unal-edigital1-2019-2/work04-proyectofinal-grupo-02-1/docs/figs/Diagrama2.jpeg

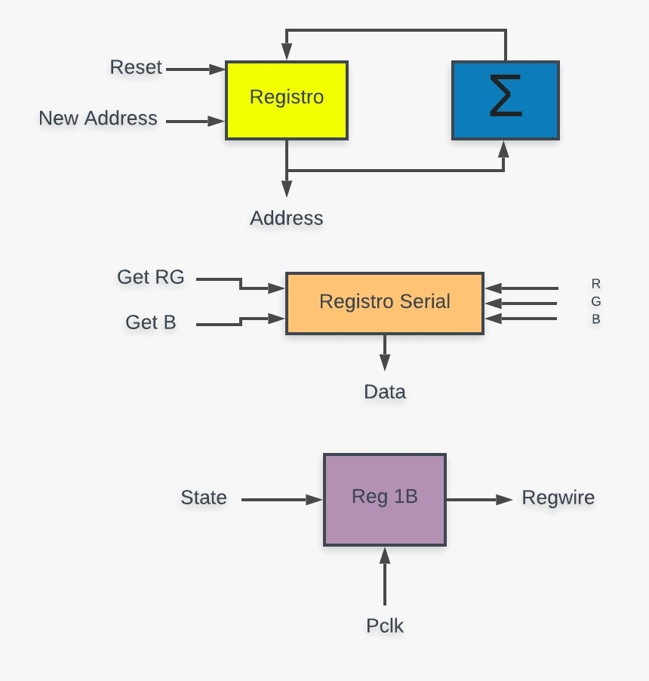
docs/figs/Diagrama2.jpeg
