unal-edigital1-2019-2/work04-proyectofinal-grupo-02-1/docs/figs/Proyecto-05.jpeg

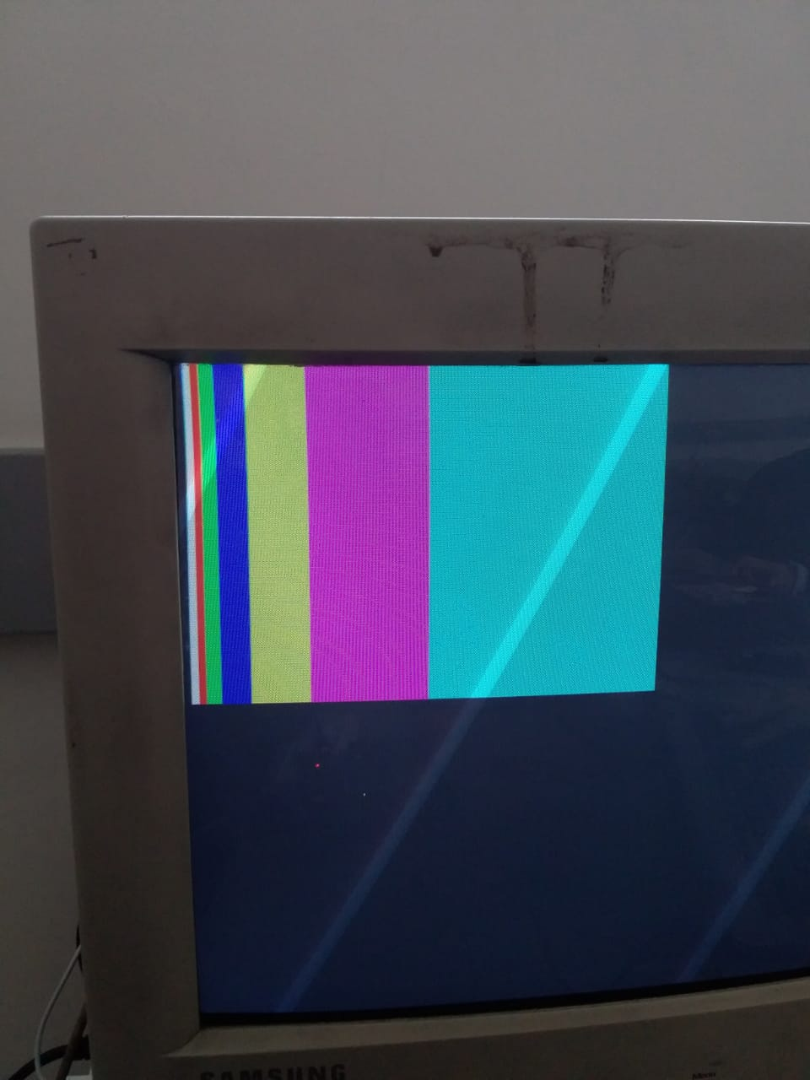
docs/figs/Proyecto-05.jpeg
