unal-edigital1-2019-2/work04-proyectofinal-grupo-02-1/docs/figs/Simulacion-00.png

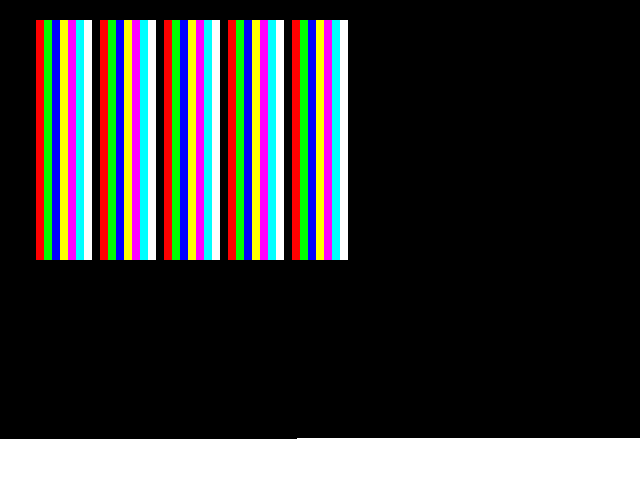
docs/figs/Simulacion-00.png
