unal-edigital1-2019-2/work04-proyectofinal-grupo-02-1/(list of files, cad)

Other CAD files:
hdl/isim/test_cam_TB_isim_beh.exe.sim/work/test_cam_TB_isim_beh.exe_main.nt64.obj
hdl/isim/test_cam_TB_isim_beh.exe.sim/unisims_ver/m_00000000004277362592_3949463703.nt64.obj
hdl/isim/test_cam_TB_isim_beh.exe.sim/work/m_00000000001073926473_1206468233.nt64.obj
hdl/isim/test_cam_TB_isim_beh.exe.sim/unisims_ver/m_00000000003266096158_2593380106.nt64.obj
hdl/isim/test_cam_TB_isim_beh.exe.sim/work/m_00000000002068633926_3409011990.nt64.obj
hdl/isim/test_cam_TB_isim_beh.exe.sim/work/m_00000000001964925841_2406606927.nt64.obj
hdl/isim/test_cam_TB_isim_beh.exe.sim/work/m_00000000004134447467_2073120511.nt64.obj
hdl/isim/test_cam_TB_isim_beh.exe.sim/work/m_00000000000293240281_0898626419.nt64.obj
hdl/isim/test_cam_TB_isim_beh.exe.sim/work/m_00000000001994499703_2888191379.nt64.obj
hdl/isim/test_cam_TB_isim_beh.exe.sim/work/m_00000000001433017019_1742765518.nt64.obj
