unal-edigital1-2019-2/work04-proyectofinal-grupo-02-1/hdl/par_usage_statistics.html

Par Statistics

Total Non-vccgnd Signals=209

Total Non-vccgnd Design Pins=2888

Total Non-vccgnd Conns=2888

Total Non-vccgnd Timing Constrained Conns=2757

Phase 1 CPU=62.1 sec

Phase 2 CPU=63.8 sec

Phase 3 CPU=68.9 sec

Phase 4 CPU=114.2 sec

Phase 5 CPU=118.2 sec

Phase 6 CPU=118.2 sec

Phase 7 CPU=118.2 sec

Phase 8 CPU=118.2 sec

Phase 9 CPU=119.3 sec

AvgWirelenPerPin Fanout 1=17.0

AvgWirelenPerPin Fanout 2=27.5

AvgWirelenPerPin Fanout 3=12.3

AvgWirelenPerPin Fanout 4=7.8

AvgWirelenPerPin Fanout 10=9.4

AvgWirelenPerPin Fanout 50=5.4

AvgWirelenPerPin Fanout 100=15.2

AvgWirelenPerPin Fanout 500=4.9

AvgWirelenPerPin Fanout 5000=0.0

AvgWirelenPerPin Fanout 20000=0.0

AvgWirelenPerPin Fanout 50000=0.0

AvgWirelenPerPin Fanout 100000=0.0

IRR Gamma=1.0083
