unal-edigital1-2019-2/work04-proyectofinal-grupo-02-1/hdl/usage_statistics_webtalk.html

### Device Usage Page (usage_statistics_webtalk.html)

This HTML page displays the device usage statistics that will be sent to Xilinx.

Software Version and Target Device
Product Version: | ISE:14.7 (WebPack) - P.20131013 | Target Family: | Artix7
OS Platform: | NT64 | Target Device: | xc7a100t
Project ID (random number) | fe5249351b4f4ad88650da59bd6b6d94.874A876191364FBEB39825A02CC45C05.1 | Target Package: | csg324
Registration ID | 211795229_0_0_235 | Target Speed: | -3
Date Generated | 2020-02-10T19:30:09 | Tool Flow | ISE

User Environment
OS Name | Microsoft , 64-bit | OS Release | major release (build 9200)
CPU Name | Intel(R) Core(TM) i5-4300U CPU @ 1.90GHz | CPU Speed | 2494 MHz
OS Name | Microsoft , 64-bit | OS Release | major release (build 9200)
CPU Name | Intel(R) Core(TM) i5-4300U CPU @ 1.90GHz | CPU Speed | 2494 MHz

Device Usage Statistics
Macro Statistics | Miscellaneous Statistics | Net Statistics | Site Usage

Adders/Subtractors=1

17-bit adder=1

Comparators=8

10-bit comparator greater=4

10-bit comparator lessequal=1

9-bit comparator greater=2

9-bit comparator lessequal=1

Counters=2

10-bit up counter=1

9-bit up counter=1

FSMs=1 MACs=1

9x9-to-17-bit MAC=1

Multiplexers=2

17-bit 2-to-1 multiplexer=1

8-bit 2-to-1 multiplexer=1

RAMs=1

131072x8-bit dual-port block RAM=1

Registers=26

Flip-Flops=26

MiscellaneousStatistics

AGG_BONDED_IO=31

AGG_IO=31

AGG_LOCED_IO=31

AGG_SLICE=52

NUM_BONDED_IOB33=31

NUM_BSFULL=48

NUM_BSLUTONLY=64

NUM_BSUSED=112

NUM_BUFG=5

NUM_LOCED_IOB33=31

NUM_LOGIC_O5ANDO6=15

NUM_LOGIC_O5ONLY=37

NUM_LOGIC_O6ONLY=55

NUM_LUT_RT_DRIVES_CARRY4=5

NUM_LUT_RT_EXO6=5

NUM_LUT_RT_O6=37

NUM_MMCME2_ADV=1

NUM_RAMB36E1=32

NUM_SLICEL=52

NUM_SLICE_CARRY4=17

NUM_SLICE_CONTROLSET=5

NUM_SLICE_CYINIT=169

NUM_SLICE_FF=49

NUM_SLICE_UNUSEDCTRL=30

NUM_UNUSABLE_FF_BELS=23

NetStatistics

NumNets_Active=240

NumNets_Gnd=1

NumNets_Vcc=1

NumNodesOfType_Active_BENTQUAD=177

NumNodesOfType_Active_BOUNCEACROSS=76

NumNodesOfType_Active_BOUNCEIN=49

NumNodesOfType_Active_BUFGROUT=5

NumNodesOfType_Active_BUFINP2OUT=8

NumNodesOfType_Active_CLKPIN=157

NumNodesOfType_Active_DOUBLE=509

NumNodesOfType_Active_GENERIC=18

NumNodesOfType_Active_GLOBAL=145

NumNodesOfType_Active_HLONG=35

NumNodesOfType_Active_HQUAD=217

NumNodesOfType_Active_INPUT=2370

NumNodesOfType_Active_IOBIN2OUT=25

NumNodesOfType_Active_IOBOUTPUT=25

NumNodesOfType_Active_LUTINPUT=350

NumNodesOfType_Active_OUTBOUND=187

NumNodesOfType_Active_OUTPUT=201

NumNodesOfType_Active_PADINPUT=11

NumNodesOfType_Active_PADOUTPUT=14

NumNodesOfType_Active_PINBOUNCE=137

NumNodesOfType_Active_PINFEED=4501

NumNodesOfType_Active_SINGLE=602

NumNodesOfType_Active_VLONG=68

NumNodesOfType_Active_VLONG12=54

NumNodesOfType_Active_VQUAD=205

NumNodesOfType_Gnd_BOUNCEIN=271

NumNodesOfType_Gnd_CLKPIN=131

NumNodesOfType_Gnd_HVCCGNDOUT=170

NumNodesOfType_Gnd_INPUT=924

NumNodesOfType_Gnd_IOBIN2OUT=6

NumNodesOfType_Gnd_IOBOUTPUT=6

NumNodesOfType_Gnd_PADINPUT=6

NumNodesOfType_Gnd_PINBOUNCE=195

NumNodesOfType_Gnd_PINFEED=1062

NumNodesOfType_Vcc_HVCCGNDOUT=53

NumNodesOfType_Vcc_INPUT=129

NumNodesOfType_Vcc_LUTINPUT=52

NumNodesOfType_Vcc_PINFEED=181

SiteStatistics

BUFG-BUFGCTRL=5

IOB33-IOB33M=14

IOB33-IOB33S=15

RAMB36E1-RAMBFIFO36E1=32

SLICEL-SLICEM=15

SiteSummary

BUFG=5

BUFG_BUFG=5

CARRY4=17

FF_INIT=1

HARD0=5

IOB33=31

IOB33_INBUF_EN=14

IOB33_OUTBUF=17

LUT5=52

LUT6=112

MMCME2_ADV=1

MMCME2_ADV_MMCME2_ADV=1

PAD=31

RAMB36E1=32

RAMB36E1_RAMB36E1=32

REG_INIT=48

SLICEL=52

Configuration Data

FF_INIT

CK=[CK:1] [CK_INV:0]

FFINIT=[INIT1:1]

FFSR=[SRHIGH:1]

SYNC_ATTR=[SYNC:1]

IOB33_INBUF_EN

IBUF_LOW_PWR=[TRUE:14]

MMCME2_ADV

CLKINSEL=[CLKINSEL:1] [CLKINSEL_INV:0]

PSEN=[PSEN_INV:0] [PSEN:1]

PSINCDEC=[PSINCDEC:1] [PSINCDEC_INV:0]

PWRDWN=[PWRDWN_INV:0] [PWRDWN:1]

RST=[RST:1] [RST_INV:0]

MMCME2_ADV_MMCME2_ADV

BANDWIDTH=[OPTIMIZED:1]

CLKBURST_ENABLE=[FALSE:1]

CLKBURST_REPEAT=[FALSE:1]

CLKFBIN_EDGE=[FALSE:1]

CLKFBIN_NOCOUNT=[TRUE:1]

CLKFBOUT_EDGE=[FALSE:1]

CLKFBOUT_EN=[TRUE:1]

CLKFBOUT_FRAC_EN=[FALSE:1]

CLKFBOUT_FRAC_WF_FALL=[FALSE:1]

CLKFBOUT_FRAC_WF_RISE=[FALSE:1]

CLKFBOUT_NOCOUNT=[TRUE:1]

CLKFBOUT_USE_FINE_PS=[FALSE:1]

CLKINSEL=[CLKINSEL:1] [CLKINSEL_INV:0]

CLKOUT0_EDGE=[FALSE:1]

CLKOUT0_EN=[FALSE:1]

CLKOUT0_FRAC_EN=[FALSE:1]

CLKOUT0_FRAC_WF_FALL=[FALSE:1]

CLKOUT0_FRAC_WF_RISE=[FALSE:1]

CLKOUT0_NOCOUNT=[TRUE:1]

CLKOUT0_USE_FINE_PS=[FALSE:1]

CLKOUT1_EDGE=[FALSE:1]

CLKOUT1_EN=[FALSE:1]

CLKOUT1_NOCOUNT=[TRUE:1]

CLKOUT1_USE_FINE_PS=[FALSE:1]

CLKOUT2_EDGE=[FALSE:1]

CLKOUT2_EN=[FALSE:1]

CLKOUT2_NOCOUNT=[TRUE:1]

CLKOUT2_USE_FINE_PS=[FALSE:1]

CLKOUT3_EDGE=[FALSE:1]

CLKOUT3_EN=[FALSE:1]

CLKOUT3_NOCOUNT=[TRUE:1]

CLKOUT3_USE_FINE_PS=[FALSE:1]

CLKOUT4_CASCADE=[FALSE:1]

CLKOUT4_EDGE=[FALSE:1]

CLKOUT4_EN=[FALSE:1]

CLKOUT4_NOCOUNT=[TRUE:1]

CLKOUT4_USE_FINE_PS=[FALSE:1]

CLKOUT5_EDGE=[FALSE:1]

CLKOUT5_EN=[FALSE:1]

CLKOUT5_NOCOUNT=[TRUE:1]

CLKOUT5_USE_FINE_PS=[FALSE:1]

CLKOUT6_EDGE=[FALSE:1]

CLKOUT6_EN=[FALSE:1]

CLKOUT6_NOCOUNT=[TRUE:1]

CLKOUT6_USE_FINE_PS=[FALSE:1]

COMPENSATION=[BUF_IN:1]

DIRECT_PATH_CNTRL=[FALSE:1]

DIVCLK_EDGE=[FALSE:1]

DIVCLK_NOCOUNT=[TRUE:1]

EN_VCO_DIV1=[FALSE:1]

EN_VCO_DIV6=[FALSE:1]

GTS_WAIT=[FALSE:1]

HVLF_CNT_TEST_EN=[FALSE:1]

INTERP_TEST=[FALSE:1]

IN_DLY_EN=[TRUE:1]

LF_LOW_SEL=[FALSE:1]

MMCM_EN=[TRUE:1]

PERF0_USE_CLK=[FALSE:1]

PERF1_USE_CLK=[FALSE:1]

PERF2_USE_CLK=[FALSE:1]

PERF3_USE_CLK=[FALSE:1]

PSEN=[PSEN_INV:0] [PSEN:1]

PSINCDEC=[PSINCDEC:1] [PSINCDEC_INV:0]

PWRDWN=[PWRDWN_INV:0] [PWRDWN:1]

RST=[RST:1] [RST_INV:0]

SEL_HV_NMOS=[FALSE:1]

SEL_LV_NMOS=[FALSE:1]

SEL_SLIPD=[FALSE:1]

SS_EN=[FALSE:1]

SS_MODE=[CENTER_HIGH:1]

STARTUP_WAIT=[FALSE:1]

SUP_SEL_AREG=[FALSE:1]

SUP_SEL_DREG=[FALSE:1]

TMUX_MUX_SEL=[00:1]

VLF_HIGH_DIS_B=[TRUE:1]

VLF_HIGH_PWDN_B=[TRUE:1]

RAMB36E1

CLKARDCLKL=[CLKARDCLKL:32] [CLKARDCLKL_INV:0]

CLKARDCLKU=[CLKARDCLKU_INV:0] [CLKARDCLKU:32]

CLKBWRCLKL=[CLKBWRCLKL_INV:0] [CLKBWRCLKL:32]

CLKBWRCLKU=[CLKBWRCLKU:32] [CLKBWRCLKU_INV:0]

ENARDENL=[ENARDENL_INV:0] [ENARDENL:32]

ENARDENU=[ENARDENU_INV:0] [ENARDENU:32]

ENBWRENL=[ENBWRENL:32] [ENBWRENL_INV:0]

ENBWRENU=[ENBWRENU_INV:0] [ENBWRENU:32]

REGCLKARDRCLKL=[REGCLKARDRCLKL_INV:0] [REGCLKARDRCLKL:32]

REGCLKARDRCLKU=[REGCLKARDRCLKU:32] [REGCLKARDRCLKU_INV:0]

REGCLKBL=[REGCLKBL_INV:0] [REGCLKBL:32]

REGCLKBU=[REGCLKBU:32] [REGCLKBU_INV:0]

RSTRAMARSTRAML=[RSTRAMARSTRAML_INV:0] [RSTRAMARSTRAML:32]

RSTRAMARSTRAMU=[RSTRAMARSTRAMU:32] [RSTRAMARSTRAMU_INV:0]

RSTRAMBL=[RSTRAMBL_INV:0] [RSTRAMBL:32]

RSTRAMBU=[RSTRAMBU:32] [RSTRAMBU_INV:0]

RSTREGARSTREGL=[RSTREGARSTREGL:32] [RSTREGARSTREGL_INV:0]

RSTREGARSTREGU=[RSTREGARSTREGU_INV:0] [RSTREGARSTREGU:32]

RSTREGBL=[RSTREGBL:32] [RSTREGBL_INV:0]

RSTREGBU=[RSTREGBU:32] [RSTREGBU_INV:0]

RAMB36E1_RAMB36E1

CLKARDCLKL=[CLKARDCLKL:32] [CLKARDCLKL_INV:0]

CLKARDCLKU=[CLKARDCLKU_INV:0] [CLKARDCLKU:32]

CLKBWRCLKL=[CLKBWRCLKL_INV:0] [CLKBWRCLKL:32]

CLKBWRCLKU=[CLKBWRCLKU:32] [CLKBWRCLKU_INV:0]

DOA_REG=[0:32]

DOB_REG=[0:32]

ENARDENL=[ENARDENL_INV:0] [ENARDENL:32]

ENARDENU=[ENARDENU_INV:0] [ENARDENU:32]

ENBWRENL=[ENBWRENL:32] [ENBWRENL_INV:0]

ENBWRENU=[ENBWRENU_INV:0] [ENBWRENU:32]

EN_ECC_READ=[FALSE:32]

EN_ECC_WRITE=[FALSE:32]

EN_PWRGATE=[NONE:32]

RAM_EXTENSION_A=[UPPER:16] [LOWER:16]

RAM_EXTENSION_B=[UPPER:16] [LOWER:16]

RAM_MODE=[TDP:32]

RDADDR_COLLISION_HWCONFIG=[DELAYED_WRITE:32]

READ_WIDTH_A=[1:32]

READ_WIDTH_B=[1:32]

REGCLKARDRCLKL=[REGCLKARDRCLKL_INV:0] [REGCLKARDRCLKL:32]

REGCLKARDRCLKU=[REGCLKARDRCLKU:32] [REGCLKARDRCLKU_INV:0]

REGCLKBL=[REGCLKBL_INV:0] [REGCLKBL:32]

REGCLKBU=[REGCLKBU:32] [REGCLKBU_INV:0]

RSTRAMARSTRAML=[RSTRAMARSTRAML_INV:0] [RSTRAMARSTRAML:32]

RSTRAMARSTRAMU=[RSTRAMARSTRAMU:32] [RSTRAMARSTRAMU_INV:0]

RSTRAMBL=[RSTRAMBL_INV:0] [RSTRAMBL:32]

RSTRAMBU=[RSTRAMBU:32] [RSTRAMBU_INV:0]

RSTREGARSTREGL=[RSTREGARSTREGL:32] [RSTREGARSTREGL_INV:0]

RSTREGARSTREGU=[RSTREGARSTREGU_INV:0] [RSTREGARSTREGU:32]

RSTREGBL=[RSTREGBL:32] [RSTREGBL_INV:0]

RSTREGBU=[RSTREGBU:32] [RSTREGBU_INV:0]

RSTREG_PRIORITY_A=[RSTREG:32]

RSTREG_PRIORITY_B=[RSTREG:32]

SAVEDATA=[FALSE:32]

WRITE_MODE_A=[WRITE_FIRST:32]

WRITE_MODE_B=[WRITE_FIRST:32]

WRITE_WIDTH_A=[1:32]

WRITE_WIDTH_B=[1:32]

REG_INIT

CK=[CK:48] [CK_INV:0]

FFINIT=[INIT0:43] [INIT1:5]

FFSR=[SRLOW:43] [SRHIGH:5]

LATCH_OR_FF=[FF:48]

SYNC_ATTR=[ASYNC:30] [SYNC:18]

SLICEL

CLK=[CLK:22] [CLK_INV:0]

Pin Data

BUFG

I0=5

O=5

BUFG_BUFG

I0=5

O=5

CARRY4

CIN=12

CO3=12

CYINIT=5

DI0=14

DI1=13

DI2=12

DI3=12

O0=17

O1=14

O2=13

O3=12

S0=17

S1=14

S2=13

S3=12

FF_INIT

CK=1

D=1

Q=1

SR=1

HARD0

0=5

IOB33

I=14

O=17

PAD=31

IOB33_INBUF_EN

OUT=14

PAD=14

IOB33_OUTBUF

IN=17

OUT=17

LUT5

A1=1

A2=3

A3=10

A4=11

A5=3

O5=52

LUT6

A1=31

A2=40

A3=45

A4=72

A5=91

A6=111

O6=112

MMCME2_ADV

CLKFBIN=1

CLKFBOUT=1

CLKIN1=1

CLKIN2=1

CLKINSEL=1

CLKOUT0=1

CLKOUT1=1

DADDR0=1

DADDR1=1

DADDR2=1

DADDR3=1

DADDR4=1

DADDR5=1

DADDR6=1

DCLK=1

DEN=1

DI0=1

DI1=1

DI10=1

DI11=1

DI12=1

DI13=1

DI14=1

DI15=1

DI2=1

DI3=1

DI4=1

DI5=1

DI6=1

DI7=1

DI8=1

DI9=1

DWE=1

PSCLK=1

PSEN=1

PSINCDEC=1

PWRDWN=1

RST=1

MMCME2_ADV_MMCME2_ADV

CLKFBIN=1

CLKFBOUT=1

CLKIN1=1

CLKIN2=1

CLKINSEL=1

CLKOUT0=1

CLKOUT1=1

DADDR0=1

DADDR1=1

DADDR2=1

DADDR3=1

DADDR4=1

DADDR5=1

DADDR6=1

DCLK=1

DEN=1

DI0=1

DI1=1

DI10=1

DI11=1

DI12=1

DI13=1

DI14=1

DI15=1

DI2=1

DI3=1

DI4=1

DI5=1

DI6=1

DI7=1

DI8=1

DI9=1

DWE=1

PSCLK=1

PSEN=1

PSINCDEC=1

PWRDWN=1

RST=1

PAD

PAD=31

RAMB36E1

ADDRARDADDRL0=32

ADDRARDADDRL1=32

ADDRARDADDRL10=32

ADDRARDADDRL11=32

ADDRARDADDRL12=32

ADDRARDADDRL13=32

ADDRARDADDRL14=32

ADDRARDADDRL15=32

ADDRARDADDRL2=32

ADDRARDADDRL3=32

ADDRARDADDRL4=32

ADDRARDADDRL5=32

ADDRARDADDRL6=32

ADDRARDADDRL7=32

ADDRARDADDRL8=32

ADDRARDADDRL9=32

ADDRARDADDRU0=32

ADDRARDADDRU1=32

ADDRARDADDRU10=32

ADDRARDADDRU11=32

ADDRARDADDRU12=32

ADDRARDADDRU13=32

ADDRARDADDRU14=32

ADDRARDADDRU2=32

ADDRARDADDRU3=32

ADDRARDADDRU4=32

ADDRARDADDRU5=32

ADDRARDADDRU6=32

ADDRARDADDRU7=32

ADDRARDADDRU8=32

ADDRARDADDRU9=32

ADDRBWRADDRL0=32

ADDRBWRADDRL1=32

ADDRBWRADDRL10=32

ADDRBWRADDRL11=32

ADDRBWRADDRL12=32

ADDRBWRADDRL13=32

ADDRBWRADDRL14=32

ADDRBWRADDRL15=32

ADDRBWRADDRL2=32

ADDRBWRADDRL3=32

ADDRBWRADDRL4=32

ADDRBWRADDRL5=32

ADDRBWRADDRL6=32

ADDRBWRADDRL7=32

ADDRBWRADDRL8=32

ADDRBWRADDRL9=32

ADDRBWRADDRU0=32

ADDRBWRADDRU1=32

ADDRBWRADDRU10=32

ADDRBWRADDRU11=32

ADDRBWRADDRU12=32

ADDRBWRADDRU13=32

ADDRBWRADDRU14=32

ADDRBWRADDRU2=32

ADDRBWRADDRU3=32

ADDRBWRADDRU4=32

ADDRBWRADDRU5=32

ADDRBWRADDRU6=32

ADDRBWRADDRU7=32

ADDRBWRADDRU8=32

ADDRBWRADDRU9=32

CASCADEINA=16

CASCADEINB=16

CASCADEOUTA=16

CASCADEOUTB=16

CLKARDCLKL=32

CLKARDCLKU=32

CLKBWRCLKL=32

CLKBWRCLKU=32

DIADI0=32

DIADI1=32

DOBDO0=16

ENARDENL=32

ENARDENU=32

ENBWRENL=32

ENBWRENU=32

REGCEAREGCEL=32

REGCEAREGCEU=32

REGCEBL=32

REGCEBU=32

REGCLKARDRCLKL=32

REGCLKARDRCLKU=32

REGCLKBL=32

REGCLKBU=32

RSTRAMARSTRAML=32

RSTRAMARSTRAMU=32

RSTRAMBL=32

RSTRAMBU=32

RSTREGARSTREGL=32

RSTREGARSTREGU=32

RSTREGBL=32

RSTREGBU=32

WEAL0=32

WEAL1=32

WEAL2=32

WEAL3=32

WEAU0=32

WEAU1=32

WEAU2=32

WEAU3=32

WEBWEL0=32

WEBWEL1=32

WEBWEL2=32

WEBWEL3=32

WEBWEL4=32

WEBWEL5=32

WEBWEL6=32

WEBWEL7=32

WEBWEU0=32

WEBWEU1=32

WEBWEU2=32

WEBWEU3=32

WEBWEU4=32

WEBWEU5=32

WEBWEU6=32

WEBWEU7=32

RAMB36E1_RAMB36E1

ADDRARDADDRL0=32

ADDRARDADDRL1=32

ADDRARDADDRL10=32

ADDRARDADDRL11=32

ADDRARDADDRL12=32

ADDRARDADDRL13=32

ADDRARDADDRL14=32

ADDRARDADDRL15=32

ADDRARDADDRL2=32

ADDRARDADDRL3=32

ADDRARDADDRL4=32

ADDRARDADDRL5=32

ADDRARDADDRL6=32

ADDRARDADDRL7=32

ADDRARDADDRL8=32

ADDRARDADDRL9=32

ADDRARDADDRU0=32

ADDRARDADDRU1=32

ADDRARDADDRU10=32

ADDRARDADDRU11=32

ADDRARDADDRU12=32

ADDRARDADDRU13=32

ADDRARDADDRU14=32

ADDRARDADDRU2=32

ADDRARDADDRU3=32

ADDRARDADDRU4=32

ADDRARDADDRU5=32

ADDRARDADDRU6=32

ADDRARDADDRU7=32

ADDRARDADDRU8=32

ADDRARDADDRU9=32

ADDRBWRADDRL0=32

ADDRBWRADDRL1=32

ADDRBWRADDRL10=32

ADDRBWRADDRL11=32

ADDRBWRADDRL12=32

ADDRBWRADDRL13=32

ADDRBWRADDRL14=32

ADDRBWRADDRL15=32

ADDRBWRADDRL2=32

ADDRBWRADDRL3=32

ADDRBWRADDRL4=32

ADDRBWRADDRL5=32

ADDRBWRADDRL6=32

ADDRBWRADDRL7=32

ADDRBWRADDRL8=32

ADDRBWRADDRL9=32

ADDRBWRADDRU0=32

ADDRBWRADDRU1=32

ADDRBWRADDRU10=32

ADDRBWRADDRU11=32

ADDRBWRADDRU12=32

ADDRBWRADDRU13=32

ADDRBWRADDRU14=32

ADDRBWRADDRU2=32

ADDRBWRADDRU3=32

ADDRBWRADDRU4=32

ADDRBWRADDRU5=32

ADDRBWRADDRU6=32

ADDRBWRADDRU7=32

ADDRBWRADDRU8=32

ADDRBWRADDRU9=32

CASCADEINA=16

CASCADEINB=16

CASCADEOUTA=16

CASCADEOUTB=16

CLKARDCLKL=32

CLKARDCLKU=32

CLKBWRCLKL=32

CLKBWRCLKU=32

DIADI0=32

DIADI1=32

DOBDO0=16

ENARDENL=32

ENARDENU=32

ENBWRENL=32

ENBWRENU=32

REGCEAREGCEL=32

REGCEAREGCEU=32

REGCEBL=32

REGCEBU=32

REGCLKARDRCLKL=32

REGCLKARDRCLKU=32

REGCLKBL=32

REGCLKBU=32

RSTRAMARSTRAML=32

RSTRAMARSTRAMU=32

RSTRAMBL=32

RSTRAMBU=32

RSTREGARSTREGL=32

RSTREGARSTREGU=32

RSTREGBL=32

RSTREGBU=32

WEAL0=32

WEAL1=32

WEAL2=32

WEAL3=32

WEAU0=32

WEAU1=32

WEAU2=32

WEAU3=32

WEBWEL0=32

WEBWEL1=32

WEBWEL2=32

WEBWEL3=32

WEBWEL4=32

WEBWEL5=32

WEBWEL6=32

WEBWEL7=32

WEBWEU0=32

WEBWEU1=32

WEBWEU2=32

WEBWEU3=32

WEBWEU4=32

WEBWEU5=32

WEBWEU6=32

WEBWEU7=32

REG_INIT

CE=9

CK=48

D=48

Q=48

SR=18

SLICEL

A=11

A1=13

A2=16

A3=17

A4=24

A5=28

A6=35

AMUX=13

AQ=15

AX=3

B=6

B1=6

B2=8

B3=13

B4=17

B5=22

B6=27

BMUX=14

BQ=12

BX=3

C=2

C1=5

C2=8

C3=10

C4=14

C5=18

C6=23

CE=3

CIN=12

CLK=22

CMUX=9

COUT=12

CQ=12

CX=3

D=9

D1=8

D2=10

D3=14

D4=17

D5=23

D6=26

DMUX=15

DQ=9

DX=2

SR=7

Tool Usage

Command Line History

xst -intstyle ise -ifn <ise_file>

ngdbuild -intstyle ise -dd _ngo -nt timestamp -uc <ise_file> <fname>.ngd

map -intstyle ise -p xc7a100t-csg324-3 -w -logic_opt off -ol high -t 1 -xt 0 -register_duplication off -r 4 -mt off -ir off -pr off -lc off -power off -o <fname>.ncd <fname>.ngd <fname>.pcf

par -w -intstyle ise -ol high -mt off <fname>.ncd <fname>.ncd <fname>.pcf

trce -intstyle ise -v 3 -s 3 -n 3 -fastpaths -xml <fname>.twx <fname>.ncd -o <fname>.twr <fname>.pcf

bitgen -intstyle ise -f <fname>.ut <fname>.ncd

fuse

Software Quality
Run Statistics
Program Name | Runs Started | Runs Finished | Errors | Fatal Errors | Internal Errors | Exceptions | Core Dumps
bitgen | 17 | 17 | 0 | 0 | 0 | 0 | 0
map | 23 | 19 | 0 | 0 | 0 | 0 | 0
ngdbuild | 25 | 25 | 0 | 0 | 0 | 0 | 0
par | 19 | 18 | 1 | 0 | 0 | 0 | 0
trce | 17 | 17 | 0 | 0 | 0 | 0 | 0
xst | 52 | 48 | 0 | 0 | 0 | 0 | 0

Project Statistics
PROPEXT_xilxSynthAddBufg_virtex5=16 | PROP_Enable_Message_Filtering=false
PROP_FitterReportFormat=HTML | PROP_LastAppliedGoal=Balanced
PROP_LastAppliedStrategy=Xilinx Default (unlocked) | PROP_ManualCompileOrderImp=false
PROP_PropSpecInProjFile=Store all values | PROP_SelectedInstanceHierarchicalPath=/test_cam_TB
PROP_Simulator=ISim (VHDL/Verilog) | PROP_SynthTopFile=changed
PROP_Top_Level_Module_Type=HDL | PROP_UseSmartGuide=false
PROP_UserConstraintEditorPreference=Text Editor | PROP_intProjectCreationTimestamp=2019-11-04T10:43:54
PROP_intWbtProjectID=874A876191364FBEB39825A02CC45C05 | PROP_intWbtProjectIteration=1
PROP_intWorkingDirLocWRTProjDir=Same | PROP_intWorkingDirUsed=No
PROP_selectedSimRootSourceNode_behav=work.test_cam_TB | PROP_AutoTop=false
PROP_DevFamily=Artix7 | PROP_DevDevice=xc7a100t
PROP_DevFamilyPMName=artix7 | PROP_ISimSimulationRunTime_behav_tb=30 ms
PROP_DevPackage=csg324 | PROP_Synthesis_Tool=XST (VHDL/Verilog)
PROP_DevSpeed=-3 | PROP_PreferredLanguage=Verilog
FILE_UCF=1 | FILE_VERILOG=6

Core Statistics
Core Type=clk_wiz_v3_6
clkin1_period=10.000 | clkin2_period=10.000 | clock_mgr_type=MANUAL | feedback_source=FDBK_AUTO
feedback_type=SINGLE | manual_override=false | num_out_clk=2 | primtype_sel=MMCM_ADV
use_clk_valid=false | use_dyn_phase_shift=false | use_dyn_reconfig=false | use_freeze=false
use_inclk_stopped=false | use_inclk_switchover=false | use_locked=true | use_max_i_jitter=false
use_min_o_jitter=false | use_phase_alignment=true | use_power_down=false | use_reset=true

use_status=false

Unisim Statistics
XST_UNISIM_SUMMARY

XST_NUM_BUFG=1
NGDBUILD_PRE_UNISIM_SUMMARY
NGDBUILD_NUM_BUFG=4 | NGDBUILD_NUM_BUFGP=1 | NGDBUILD_NUM_FD=30 | NGDBUILD_NUM_FDR=8
NGDBUILD_NUM_FDRE=5 | NGDBUILD_NUM_FDS=2 | NGDBUILD_NUM_FDSE=4 | NGDBUILD_NUM_GND=1
NGDBUILD_NUM_IBUF=12 | NGDBUILD_NUM_IBUFG=1 | NGDBUILD_NUM_INV=3 | NGDBUILD_NUM_LUT1=41
NGDBUILD_NUM_LUT2=31 | NGDBUILD_NUM_LUT3=3 | NGDBUILD_NUM_LUT4=6 | NGDBUILD_NUM_LUT5=8
NGDBUILD_NUM_LUT6=31 | NGDBUILD_NUM_MMCME2_ADV=1 | NGDBUILD_NUM_MUXCY=51 | NGDBUILD_NUM_OBUF=17
NGDBUILD_NUM_RAMB36E1=32 | NGDBUILD_NUM_VCC=1 | NGDBUILD_NUM_XORCY=56
NGDBUILD_POST_UNISIM_SUMMARY
NGDBUILD_NUM_BUFG=5 | NGDBUILD_NUM_FD=30 | NGDBUILD_NUM_FDR=8 | NGDBUILD_NUM_FDRE=5
NGDBUILD_NUM_FDS=2 | NGDBUILD_NUM_FDSE=4 | NGDBUILD_NUM_GND=1 | NGDBUILD_NUM_IBUF=12
NGDBUILD_NUM_IBUFG=2 | NGDBUILD_NUM_INV=3 | NGDBUILD_NUM_LUT1=41 | NGDBUILD_NUM_LUT2=31
NGDBUILD_NUM_LUT3=3 | NGDBUILD_NUM_LUT4=6 | NGDBUILD_NUM_LUT5=8 | NGDBUILD_NUM_LUT6=31
NGDBUILD_NUM_MMCME2_ADV=1 | NGDBUILD_NUM_MUXCY=51 | NGDBUILD_NUM_OBUF=17 | NGDBUILD_NUM_RAMB36E1=32
NGDBUILD_NUM_VCC=1 | NGDBUILD_NUM_XORCY=56

XST Command Line Options
XST_OPTION_SUMMARY
-ifn=<fname>.prj | -ofn=<design_top> | -ofmt=NGC | -p=xc7a100t-3-csg324
-top=<design_top> | -opt_mode=Speed | -opt_level=1 | -power=NO
-iuc=NO | -keep_hierarchy=No | -netlist_hierarchy=As_Optimized | -rtlview=Yes
-glob_opt=AllClockNets | -read_cores=YES | -write_timing_constraints=NO | -cross_clock_analysis=NO
-bus_delimiter=<> | -slice_utilization_ratio=100 | -bram_utilization_ratio=100 | -dsp_utilization_ratio=100
-reduce_control_sets=Auto | -fsm_extract=YES | -fsm_encoding=Auto | -safe_implementation=No
-fsm_style=LUT | -ram_extract=Yes | -ram_style=Auto | -rom_extract=Yes
-shreg_extract=YES | -rom_style=Auto | -auto_bram_packing=NO | -resource_sharing=YES
-async_to_sync=NO | -use_dsp48=Auto | -iobuf=YES | -max_fanout=100000
-bufg=16 | -register_duplication=YES | -register_balancing=No | -optimize_primitives=NO
-use_clock_enable=Auto | -use_sync_set=Auto | -use_sync_reset=Auto | -iob=Auto
-equivalent_register_removal=YES | -slice_utilization_ratio_maxmargin=5

ISim Statistics

Xilinx HDL Libraries Used=unisims_ver

Fuse Resource Usage=2733 ms, 42348 KB
