unal-edigital1-2019-2/work04-proyectofinal-grupo-02-1/hdl/test_cam_summary.html

test_cam Project Status (11/04/2019 - 13:15:59)
Project File: | test_cam.xise | Parser Errors: | No Errors
Module Name: | test_cam | Implementation State: | Programming File Generated
Target Device: | xc7a100t-3csg324 | Errors: | No Errors
Product Version: | ISE 14.7 | Warnings: | 22 Warnings (22 new)
Design Goal: | Balanced | Routing Results: | All Signals Completely Routed
Design Strategy: | Xilinx Default (unlocked) | Timing Constraints: | All Constraints Met
Environment: | System Settings | Final Timing Score: | 0 (Timing Report)

Device Utilization Summary | | | | | [-]
Slice Logic Utilization | Used | Available | Utilization | Note(s)
Number of Slice Registers | 49 | 126,800 | 1%
Number used as Flip Flops | 49
Number used as Latches | 0
Number used as Latch-thrus | 0
Number used as AND/OR logics | 0
Number of Slice LUTs | 112 | 63,400 | 1%
Number used as logic | 107 | 63,400 | 1%
Number using O6 output only | 55
Number using O5 output only | 37
Number using O5 and O6 | 15
Number used as ROM | 0
Number used as Memory | 0 | 19,000 | 0%
Number used exclusively as route-thrus | 5
Number with same-slice register load | 0
Number with same-slice carry load | 5
Number with other load | 0
Number of occupied Slices | 52 | 15,850 | 1%
Number of LUT Flip Flop pairs used | 112
Number with an unused Flip Flop | 64 | 112 | 57%
Number with an unused LUT | 0 | 112 | 0%
Number of fully used LUT-FF pairs | 48 | 112 | 42%
Number of unique control sets | 5
Number of slice register sites lost to control set restrictions | 23 | 126,800 | 1%
Number of bonded IOBs | 31 | 210 | 14%
Number of LOCed IOBs | 31 | 31 | 100%
Number of RAMB36E1/FIFO36E1s | 32 | 135 | 23%
Number using RAMB36E1 only | 32
Number using FIFO36E1 only | 0
Number of RAMB18E1/FIFO18E1s | 0 | 270 | 0%
Number of BUFG/BUFGCTRLs | 5 | 32 | 15%
Number used as BUFGs | 5
Number used as BUFGCTRLs | 0
Number of IDELAYE2/IDELAYE2_FINEDELAYs | 0 | 300 | 0%
Number of ILOGICE2/ILOGICE3/ISERDESE2s | 0 | 300 | 0%
Number of ODELAYE2/ODELAYE2_FINEDELAYs | 0
Number of OLOGICE2/OLOGICE3/OSERDESE2s | 0 | 300 | 0%
Number of PHASER_IN/PHASER_IN_PHYs | 0 | 24 | 0%
Number of PHASER_OUT/PHASER_OUT_PHYs | 0 | 24 | 0%
Number of BSCANs | 0 | 4 | 0%
Number of BUFHCEs | 0 | 96 | 0%
Number of BUFRs | 0 | 24 | 0%
Number of CAPTUREs | 0 | 1 | 0%
Number of DNA_PORTs | 0 | 1 | 0%
Number of DSP48E1s | 0 | 240 | 0%
Number of EFUSE_USRs | 0 | 1 | 0%
Number of FRAME_ECCs | 0 | 1 | 0%
Number of IBUFDS_GTE2s | 0 | 4 | 0%
Number of ICAPs | 0 | 2 | 0%
Number of IDELAYCTRLs | 0 | 6 | 0%
Number of IN_FIFOs | 0 | 24 | 0%
Number of MMCME2_ADVs | 1 | 6 | 16%
Number of OUT_FIFOs | 0 | 24 | 0%
Number of PCIE_2_1s | 0 | 1 | 0%
Number of PHASER_REFs | 0 | 6 | 0%
Number of PHY_CONTROLs | 0 | 6 | 0%
Number of PLLE2_ADVs | 0 | 6 | 0%
Number of STARTUPs | 0 | 1 | 0%
Number of XADCs | 0 | 1 | 0%
Average Fanout of Non-Clock Nets | 13.43

Performance Summary | | | | [-]
Final Timing Score: | 0 (Setup: 0, Hold: 0) | Pinout Data: | Pinout Report
Routing Results: | All Signals Completely Routed | Clock Data: | Clock Report
Timing Constraints: | All Constraints Met

Detailed Reports | | | | | | [-]
Report Name | Status | Generated | Errors | Warnings | Infos
Synthesis Report | Current | lun. 10. feb. 19:16:48 2020 | 0 | 21 Warnings (21 new) | 2 Infos (2 new)
Translation Report | Current | lun. 10. feb. 19:17:36 2020 | 0 | 0 | 0
Map Report | Current | lun. 10. feb. 19:23:52 2020 | 0 | 1 Warning (1 new) | 5 Infos (5 new)
Place and Route Report | Current | lun. 10. feb. 19:26:04 2020 | 0 | 0 | 3 Infos (3 new)
Power Report
Post-PAR Static Timing Report | Current | lun. 10. feb. 19:26:54 2020 | 0 | 0 | 4 Infos (4 new)
Bitgen Report | Current | lun. 10. feb. 19:30:07 2020 | 0 | 0 | 1 Info (1 new)

Secondary Reports | | | [-]
Report Name | Status | Generated
ISIM Simulator Log | Out of Date | lun. 10. feb. 18:33:08 2020
WebTalk Report | Current | lun. 10. feb. 19:30:09 2020
WebTalk Log File | Current | lun. 10. feb. 19:30:14 2020

Date Generated: 02/10/2020 - 20:32:46
