unal-edigital1-2019-2/work04-proyectofinal-grupo-02-1/hdl/test_cam_envsettings.html

System Settings

Environment Settings
Environment Variable | xst | ngdbuild | map | par
PATHEXT | .COM; .EXE; .BAT; .CMD; .VBS; .VBE; .JS; .JSE; .WSF; .WSH; .MSC | .COM; .EXE; .BAT; .CMD; .VBS; .VBE; .JS; .JSE; .WSF; .WSH; .MSC | .COM; .EXE; .BAT; .CMD; .VBS; .VBE; .JS; .JSE; .WSF; .WSH; .MSC | .COM; .EXE; .BAT; .CMD; .VBS; .VBE; .JS; .JSE; .WSF; .WSH; .MSC

Path

C:\Xilinx\14.7\ISE_DS\ISE\\lib\nt64;
C:\Xilinx\14.7\ISE_DS\ISE\\bin\nt64;
C:\Xilinx\14.7\ISE_DS\ISE\bin\nt64;
C:\Xilinx\14.7\ISE_DS\ISE\lib\nt64;
C:\Xilinx\14.7\ISE_DS\ISE\..\..\..\DocNav;
C:\Xilinx\14.7\ISE_DS\PlanAhead\bin;
C:\Xilinx\14.7\ISE_DS\EDK\bin\nt64;
C:\Xilinx\14.7\ISE_DS\EDK\lib\nt64;
C:\Xilinx\14.7\ISE_DS\EDK\gnu\microblaze\nt\bin;
C:\Xilinx\14.7\ISE_DS\EDK\gnu\powerpc-eabi\nt\bin;
C:\Xilinx\14.7\ISE_DS\EDK\gnuwin\bin;
C:\Xilinx\14.7\ISE_DS\EDK\gnu\arm\nt\bin;
C:\Xilinx\14.7\ISE_DS\EDK\gnu\microblaze\linux_toolchain\nt64_be\bin;
C:\Xilinx\14.7\ISE_DS\EDK\gnu\microblaze\linux_toolchain\nt64_le\bin;
C:\Xilinx\14.7\ISE_DS\common\bin\nt64;
C:\Xilinx\14.7\ISE_DS\common\lib\nt64;
C:\ProgramData\Oracle\Java\javapath;
C:\Windows\system32;
C:\Windows;
C:\Windows\System32\Wbem;
C:\Windows\System32\WindowsPowerShell\v1.0\;
C:\Program Files (x86)\Skype\Phone\;
C:\Program Files (x86)\IVI Foundation\VISA\WinNT\Bin;
C:\Users\USER PC\AppData\Local\GitHubDesktop\bin

C:\Xilinx\14.7\ISE_DS\ISE\\lib\nt64;
C:\Xilinx\14.7\ISE_DS\ISE\\bin\nt64;
C:\Xilinx\14.7\ISE_DS\ISE\bin\nt64;
C:\Xilinx\14.7\ISE_DS\ISE\lib\nt64;
C:\Xilinx\14.7\ISE_DS\ISE\..\..\..\DocNav;
C:\Xilinx\14.7\ISE_DS\PlanAhead\bin;
C:\Xilinx\14.7\ISE_DS\EDK\bin\nt64;
C:\Xilinx\14.7\ISE_DS\EDK\lib\nt64;
C:\Xilinx\14.7\ISE_DS\EDK\gnu\microblaze\nt\bin;
C:\Xilinx\14.7\ISE_DS\EDK\gnu\powerpc-eabi\nt\bin;
C:\Xilinx\14.7\ISE_DS\EDK\gnuwin\bin;
C:\Xilinx\14.7\ISE_DS\EDK\gnu\arm\nt\bin;
C:\Xilinx\14.7\ISE_DS\EDK\gnu\microblaze\linux_toolchain\nt64_be\bin;
C:\Xilinx\14.7\ISE_DS\EDK\gnu\microblaze\linux_toolchain\nt64_le\bin;
C:\Xilinx\14.7\ISE_DS\common\bin\nt64;
C:\Xilinx\14.7\ISE_DS\common\lib\nt64;
C:\ProgramData\Oracle\Java\javapath;
C:\Windows\system32;
C:\Windows;
C:\Windows\System32\Wbem;
C:\Windows\System32\WindowsPowerShell\v1.0\;
C:\Program Files (x86)\Skype\Phone\;
C:\Program Files (x86)\IVI Foundation\VISA\WinNT\Bin;
C:\Users\USER PC\AppData\Local\GitHubDesktop\bin

C:\Xilinx\14.7\ISE_DS\ISE\\lib\nt64;
C:\Xilinx\14.7\ISE_DS\ISE\\bin\nt64;
C:\Xilinx\14.7\ISE_DS\ISE\bin\nt64;
C:\Xilinx\14.7\ISE_DS\ISE\lib\nt64;
C:\Xilinx\14.7\ISE_DS\ISE\..\..\..\DocNav;
C:\Xilinx\14.7\ISE_DS\PlanAhead\bin;
C:\Xilinx\14.7\ISE_DS\EDK\bin\nt64;
C:\Xilinx\14.7\ISE_DS\EDK\lib\nt64;
C:\Xilinx\14.7\ISE_DS\EDK\gnu\microblaze\nt\bin;
C:\Xilinx\14.7\ISE_DS\EDK\gnu\powerpc-eabi\nt\bin;
C:\Xilinx\14.7\ISE_DS\EDK\gnuwin\bin;
C:\Xilinx\14.7\ISE_DS\EDK\gnu\arm\nt\bin;
C:\Xilinx\14.7\ISE_DS\EDK\gnu\microblaze\linux_toolchain\nt64_be\bin;
C:\Xilinx\14.7\ISE_DS\EDK\gnu\microblaze\linux_toolchain\nt64_le\bin;
C:\Xilinx\14.7\ISE_DS\common\bin\nt64;
C:\Xilinx\14.7\ISE_DS\common\lib\nt64;
C:\ProgramData\Oracle\Java\javapath;
C:\Windows\system32;
C:\Windows;
C:\Windows\System32\Wbem;
C:\Windows\System32\WindowsPowerShell\v1.0\;
C:\Program Files (x86)\Skype\Phone\;
C:\Program Files (x86)\IVI Foundation\VISA\WinNT\Bin;
C:\Users\USER PC\AppData\Local\GitHubDesktop\bin

C:\Xilinx\14.7\ISE_DS\ISE\\lib\nt64;
C:\Xilinx\14.7\ISE_DS\ISE\\bin\nt64;
C:\Xilinx\14.7\ISE_DS\ISE\bin\nt64;
C:\Xilinx\14.7\ISE_DS\ISE\lib\nt64;
C:\Xilinx\14.7\ISE_DS\ISE\..\..\..\DocNav;
C:\Xilinx\14.7\ISE_DS\PlanAhead\bin;
C:\Xilinx\14.7\ISE_DS\EDK\bin\nt64;
C:\Xilinx\14.7\ISE_DS\EDK\lib\nt64;
C:\Xilinx\14.7\ISE_DS\EDK\gnu\microblaze\nt\bin;
C:\Xilinx\14.7\ISE_DS\EDK\gnu\powerpc-eabi\nt\bin;
C:\Xilinx\14.7\ISE_DS\EDK\gnuwin\bin;
C:\Xilinx\14.7\ISE_DS\EDK\gnu\arm\nt\bin;
C:\Xilinx\14.7\ISE_DS\EDK\gnu\microblaze\linux_toolchain\nt64_be\bin;
C:\Xilinx\14.7\ISE_DS\EDK\gnu\microblaze\linux_toolchain\nt64_le\bin;
C:\Xilinx\14.7\ISE_DS\common\bin\nt64;
C:\Xilinx\14.7\ISE_DS\common\lib\nt64;
C:\ProgramData\Oracle\Java\javapath;
C:\Windows\system32;
C:\Windows;
C:\Windows\System32\Wbem;
C:\Windows\System32\WindowsPowerShell\v1.0\;
C:\Program Files (x86)\Skype\Phone\;
C:\Program Files (x86)\IVI Foundation\VISA\WinNT\Bin;
C:\Users\USER PC\AppData\Local\GitHubDesktop\bin
XILINX | C:\Xilinx\14.7\ISE_DS\ISE\ | C:\Xilinx\14.7\ISE_DS\ISE\ | C:\Xilinx\14.7\ISE_DS\ISE\ | C:\Xilinx\14.7\ISE_DS\ISE\
XILINX_DSP | C:\Xilinx\14.7\ISE_DS\ISE | C:\Xilinx\14.7\ISE_DS\ISE | C:\Xilinx\14.7\ISE_DS\ISE | C:\Xilinx\14.7\ISE_DS\ISE
XILINX_EDK | C:\Xilinx\14.7\ISE_DS\EDK | C:\Xilinx\14.7\ISE_DS\EDK | C:\Xilinx\14.7\ISE_DS\EDK | C:\Xilinx\14.7\ISE_DS\EDK
XILINX_PLANAHEAD | C:\Xilinx\14.7\ISE_DS\PlanAhead | C:\Xilinx\14.7\ISE_DS\PlanAhead | C:\Xilinx\14.7\ISE_DS\PlanAhead | C:\Xilinx\14.7\ISE_DS\PlanAhead

Synthesis Property Settings
Switch Name | Property Name | Value | Default Value
-ifn | | test_cam.prj
-ofn | | test_cam
-ofmt | | NGC | NGC
-p | | xc7a100t-3-csg324
-top | | test_cam
-opt_mode | Optimization Goal | Speed | Speed
-opt_level | Optimization Effort | 1 | 1
-power | Power Reduction | NO | No
-iuc | Use synthesis Constraints File | NO | No
-keep_hierarchy | Keep Hierarchy | No | No
-netlist_hierarchy | Netlist Hierarchy | As_Optimized | As_Optimized
-rtlview | Generate RTL Schematic | Yes | No
-glob_opt | Global Optimization Goal | AllClockNets | AllClockNets
-read_cores | Read Cores | YES | Yes
-write_timing_constraints | Write Timing Constraints | NO | No
-cross_clock_analysis | Cross Clock Analysis | NO | No
-bus_delimiter | Bus Delimiter | <> | <>
-slice_utilization_ratio | Slice Utilization Ratio | 100 | 100
-bram_utilization_ratio | BRAM Utilization Ratio | 100 | 100
-dsp_utilization_ratio | DSP Utilization Ratio | 100 | 100
-reduce_control_sets | | Auto | Auto
-fsm_extract | | YES | Yes
-fsm_encoding | | Auto | Auto
-safe_implementation | | No | No
-fsm_style | | LUT | LUT
-ram_extract | | Yes | Yes
-ram_style | | Auto | Auto
-rom_extract | | Yes | Yes
-shreg_extract | | YES | Yes
-rom_style | | Auto | Auto
-auto_bram_packing | | NO | No
-resource_sharing | | YES | Yes
-async_to_sync | | NO | No
-use_dsp48 | | Auto | Auto
-iobuf | | YES | Yes
-max_fanout | | 100000 | 100000
-bufg | | 16 | 32
-register_duplication | | YES | Yes
-register_balancing | | No | No
-optimize_primitives | | NO | No
-use_clock_enable | | Auto | Auto
-use_sync_set | | Auto | Auto
-use_sync_reset | | Auto | Auto
-iob | | Auto | Auto
-equivalent_register_removal | | YES | Yes
-slice_utilization_ratio_maxmargin | | 5 | 0

Translation Property Settings
Switch Name | Property Name | Value | Default Value
-intstyle | | ise | None
-dd | | _ngo | None
-p | | xc7a100t-csg324-3 | None
-uc | | src/Nexys4_Master.ucf | None

Map Property Settings
Switch Name | Property Name | Value | Default Value
-ol | Place & Route Effort Level (Overall) | high | high
-xt | Extra Cost Tables | 0 | 0
-ir | Use RLOC Constraints | OFF | OFF
-t | Starting Placer Cost Table (1-100) Map | 1 | 0
-r | Register Ordering | 4 | 4
-intstyle | | ise | None
-lc | LUT Combining | off | off
-o | | test_cam_map.ncd | None
-w | | true | false
-pr | Pack I/O Registers/Latches into IOBs | off | off
-p | | xc7a100t-csg324-3 | None

Place and Route Property Settings
Switch Name | Property Name | Value | Default Value
-intstyle | | ise
-mt | Enable Multi-Threading | off | off
-ol | Place & Route Effort Level (Overall) | high | std
-w | | true | false

Operating System Information
Operating System Information | xst | ngdbuild | map | par
CPU Architecture/Speed | Intel(R) Core(TM) i5-4300U CPU @ 1.90GHz/2494 MHz | Intel(R) Core(TM) i5-4300U CPU @ 1.90GHz/2494 MHz | Intel(R) Core(TM) i5-4300U CPU @ 1.90GHz/2494 MHz | Intel(R) Core(TM) i5-4300U CPU @ 1.90GHz/2494 MHz
Host | LENOVO-T440 | LENOVO-T440 | LENOVO-T440 | LENOVO-T440
OS Name | Microsoft , 64-bit | Microsoft , 64-bit | Microsoft , 64-bit | Microsoft , 64-bit
OS Release | major release (build 9200) | major release (build 9200) | major release (build 9200) | major release (build 9200)
