unal-edigital1-2019-2/work04-proyectofinal-grupo-02-1/docs/figs/Testbench-00.png

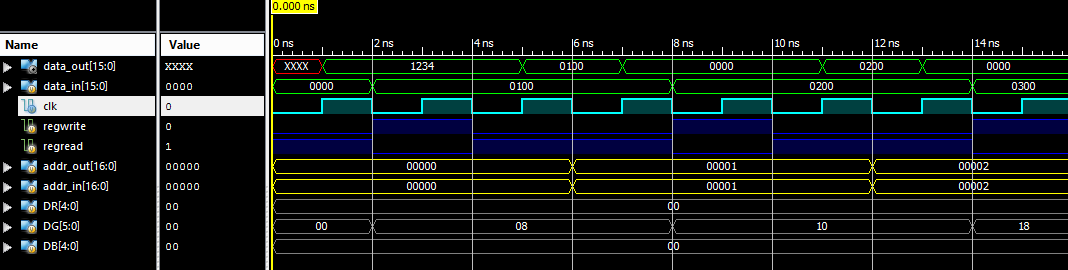
docs/figs/Testbench-00.png
