unal-edigital1-2019-2/work04-proyectofinal-grupo-02-1/hdl/src/buffer_ram_dp.v

`timescale 1ns / 1ps
//////////////////////////////////////////////////////////////////////////////////
// 
// Create Date:    13:34:31 10/22/2019 
// Design Name: 	 Ferney alberto Beltran Molina
// Module Name:    buffer_ram_dp 
// Project Name: 
// Target Devices: 
// Tool versions: 
// Description: 
//
// Dependencies: 
//
// Revision: 
// Revision 0.01 - File Created
// Additional Comments: 
//
//////////////////////////////////////////////////////////////////////////////////
module buffer_ram_dp#( 
	parameter AW = 17, // Cantidad de bits  de la dirección 
	parameter DW = 8, // cantidad de Bits de los datos 
	parameter   imageFILE= "src/image.men")
	(  
	input  clk_w, 
	input  [AW-1: 0] addr_in, 
	input  [DW-1: 0] data_in,
	input  regwrite, 
	
	input  clk_r, 
	input [AW-1: 0] addr_out,
	output reg [DW-1: 0] data_out
	);

// Calcular el número de posiciones totales de memoria 
localparam NPOS = 2 ** AW; // Memoria

 reg [DW-1: 0] ram [0: NPOS-1]; 


//	 Escritura  de la memoria port 1 
always @(posedge clk_w) begin 
       if (regwrite == 1) 
             ram[addr_in] <= data_in;
end

//	 Lectura  de la memoria port 2 
always @(posedge clk_r) begin 
		data_out <= ram[addr_out]; 
end


initial begin
	$readmemh(imageFILE, ram);
	ram[17'b11111111111111111]=8'b00000000;	
end

endmodule
