unal-edigital1-2019-2/work04-proyectofinal-grupo-02-1/hdl/src/test_cam.v

`timescale 1ns / 1ps
//////////////////////////////////////////////////////////////////////////////////
// Company: 
// Engineer: 
// 
// Create Date:    10:46:19 11/04/2019 
// Design Name: 
// Module Name:    test_cam 
// Project Name: 
// Target Devices: 
// Tool versions: 
// Description: 
//
// Dependencies: 
//
// Revision: 
// Revision 0.01 - File Created
// Additional Comments: 
//
//////////////////////////////////////////////////////////////////////////////////
module test_cam(
    input wire clk,           // board clock: 32 MHz quacho 100 MHz nexys4 
    input wire rst,         	// reset button

	// VGA input/output  
    output wire VGA_Hsync_n,  // horizontal sync output
    output wire VGA_Vsync_n,  // vertical sync output
    output wire [3:0] VGA_R,	// 4-bit VGA red output
    output wire [3:0] VGA_G,  // 4-bit VGA green output
    output wire [3:0] VGA_B,  // 4-bit VGA blue output
	
	//CAMARA input/output
	
	output wire CAM_xclk,		// System  clock imput
	output wire CAM_pwdn,		// power down mode 
	output wire CAM_reset,		// clear all registers of cam
	
	input wire CAM_pclk,
	input wire CAM_vsync,
	input wire CAM_href,
	input wire [7:0] CAM_px_data,
	input wire CBtn

		
);

// TAMAÑO DE ADQUISICIÓN DE LA CAMARA 
parameter CAM_SCREEN_X = 320;
parameter CAM_SCREEN_Y = 240;

localparam AW = 17; // LOG2(CAM_SCREEN_X*CAM_SCREEN_Y)
localparam DW = 8;

// El color es RGB 332
localparam RED_VGA =   8'b11100000;
localparam GREEN_VGA = 8'b00011100;
localparam BLUE_VGA =  8'b00000011;


// Clk 
wire clk32M;
wire clk25M;
wire clk24M;

// Conexión dual por ram

wire  [AW-1: 0] DP_RAM_addr_in;  
wire  [DW-1: 0] DP_RAM_data_in;
wire DP_RAM_regW;

reg  [AW-1: 0] DP_RAM_addr_out;  
	
// Conexión VGA Driver
wire [DW-1:0]data_mem;	   // Salida de dp_ram al driver VGA
wire [DW-1:0]data_RGB332;  // salida del driver VGA al puerto
wire [9:0]VGA_posX;		   // Determinar la pos de memoria que viene del VGA
wire [8:0]VGA_posY;		   // Determinar la pos de memoria que viene del VGA


/* ****************************************************************************
la pantalla VGA es RGB 444, pero el almacenamiento en memoria se hace 332
por lo tanto, los bits menos significactivos deben ser cero
**************************************************************************** */
assign VGA_R = {data_RGB332[7:5],1'b0};
assign VGA_G = {data_RGB332[4:2],1'b0};
assign VGA_B = {data_RGB332[1:0],2'b00};



/* ****************************************************************************
Asignación de las señales de control xclk pwdn y reset de la camara 
**************************************************************************** */

assign CAM_xclk=  clk24M;
assign CAM_pwdn=  0;			// power down mode 
assign CAM_reset=  0;

/* ****************************************************************************
	Capturadora de Datos.
	El modulo de captura adquiere los datos de la camar en formato RGB565, y
	filtra la captura a los bits mas significativos para convertirlos a formato
	RGB 332. La capturadora esta dise�ada para diemnsiones hasta 320x240.
**************************************************************************** */

Capturador_DD Captura (
	.VSYNC (CAM_vsync),
	.HREF (CAM_href),
	.PCLK (CAM_pclk),
	.D (CAM_px_data),
	.CBtn (CBtn),
	.data (DP_RAM_data_in),
	.addr (DP_RAM_addr_in),
	.regwrite (DP_RAM_regW)
);

/* ****************************************************************************
  Este bloque se debe modificar según sea le caso. El ejemplo esta dado para
  fpga Spartan6 lx9 a 32MHz.
  usar "tools -> Core Generator ..."  y general el ip con Clocking Wizard
  el bloque genera un reloj de 25Mhz usado para el VGA  y un relo de 24 MHz
  utilizado para la camara , a partir de una frecuencia de 32 Mhz
**************************************************************************** */
//assign clk32M =clk;
clk24_25_nexys4
  clk25_24(
  .CLK_IN1(clk),
  .CLK_OUT1(clk25M),
  .CLK_OUT2(clk24M),
  .RESET(rst)
 );


/* ****************************************************************************
buffer_ram_dp buffer memoria dual port y reloj de lectura y escritura separados
Se debe configurar AW  según los calculos realizados en el Wp01
se recomiendia dejar DW a 8, con el fin de optimizar recursos  y hacer RGB 332
**************************************************************************** */
buffer_ram_dp #( AW,DW)
	DP_RAM(  
	.clk_w(CAM_pclk), 
	.addr_in(DP_RAM_addr_in), 
	.data_in(DP_RAM_data_in),
	.regwrite(DP_RAM_regW), 
	
	.clk_r(clk25M), 
	.addr_out(DP_RAM_addr_out),
	.data_out(data_mem)
	);
	

/* ****************************************************************************
VGA_Driver640x480
**************************************************************************** */
VGA_Driver640x480 VGA640x480
(
	.rst(rst),
	.clk(clk25M), 				// 25MHz  para 60 hz de 640x480
	.pixelIn(data_mem), 		// entrada del valor de color  pixel RGB 332 
	.pixelOut(data_RGB332), // salida del valor pixel a la VGA 
	.Hsync_n(VGA_Hsync_n),	// señal de sincronizaciÓn en horizontal negada
	.Vsync_n(VGA_Vsync_n),	// señal de sincronizaciÓn en vertical negada 
	.posX(VGA_posX), 			// posición en horizontal del pixel siguiente
	.posY(VGA_posY) 			// posición en vertical  del pixel siguiente

);

 
/* ****************************************************************************
LÓgica para actualizar el pixel acorde con la buffer de memoria y el pixel de 
VGA si la imagen de la camara es menor que el display  VGA, los pixeles 
adicionales seran iguales al color del último pixel de memoria 
**************************************************************************** */
always @ (VGA_posX, VGA_posY) begin
		if ((VGA_posX>CAM_SCREEN_X-1) || (VGA_posY>CAM_SCREEN_Y-1))
			DP_RAM_addr_out=17'b11111111111111111;
		else
			DP_RAM_addr_out=VGA_posX+VGA_posY*CAM_SCREEN_X;
end


/*****************************************************************************
**************************************************************************** */
endmodule
