unal-edigital1-2019-2/work04-proyectofinal-grupo-02-1/hdl/src/test_cam_TB.v

`timescale 10ns / 1ns

////////////////////////////////////////////////////////////////////////////////
// Company: 
// Engineer:
//
// Create Date:   09:45:24 12/04/2019
// Design Name:   test_cam
// Module Name:   C:/Users/UECCI/Desktop/pruebas camd2/hw/src/test_cam_TB.v
// Project Name:  test_cam
// Target Device:  
// Tool versions:  
// Description: 
//
// Verilog Test Fixture created by ISE for module: test_cam
//
// Dependencies:
// 
// Revision:
// Revision 0.01 - File Created
// Additional Comments:
// 
////////////////////////////////////////////////////////////////////////////////

module test_cam_TB;

	// Inputs
	reg clk;
	reg rst;
	reg pclk;
	reg CAM_vsync;
	reg CAM_href;
	reg [7:0] CAM_px_data;
	reg CBtn;

	// Outputs
	wire VGA_Hsync_n;
	wire VGA_Vsync_n;
	wire [3:0] VGA_R;
	wire [3:0] VGA_G;
	wire [3:0] VGA_B;
	wire CAM_xclk;
	wire CAM_pwdn;
	wire CAM_reset;

	// Instantiate the Unit Under Test (UUT)
	test_cam uut (
		.clk(clk), 
		.rst(rst), 
		.VGA_Hsync_n(VGA_Hsync_n), 
		.VGA_Vsync_n(VGA_Vsync_n), 
		.VGA_R(VGA_R), 
		.VGA_G(VGA_G), 
		.VGA_B(VGA_B), 
		.CAM_xclk(CAM_xclk), 
		.CAM_pwdn(CAM_pwdn), 
		.CAM_reset(CAM_reset), 
		.CAM_pclk(pclk), 
		.CAM_vsync(CAM_vsync), 
		.CAM_href(CAM_href), 
		.CAM_px_data(CAM_px_data),
		.CBtn(CBtn)
	);
	reg img_generate=0;
	initial begin
		// Initialize Inputs
		CBtn = 1;
		clk = 0;
		rst = 1;
		pclk = 0;
		CAM_vsync = 1;
		CAM_href = 0;
		CAM_px_data = 8'b11100000;
   	// Wait 100 ns for global reset to finish
		#20;
		rst = 0;
		#1000000;
		img_generate=1;
	end

	always #0.5 clk  = ~clk;
 	always #2 pclk  = ~pclk;
	
	
	reg [9:0]line_cnt=0;
	reg [9:0]row_cnt=0;
	
	reg [3:0] count = 0;
	reg [15:0] color = 00000000;
	reg [127:0] color_data = 128'b00000000000000001111100000000000000001111110000000000000000111111111111111100000111110000001111100000111111111111111111111111111;
	
	parameter TAM_LINE=640;	// es 320x2 debido a que son dos pixeles de RGB
	parameter TAM_ROW=240;
	parameter BLACK_TAM_LINE=4;
	parameter BLACK_TAM_ROW=4;
	
	/*************************************************************************
			INICIO DE SIMULACION DE SE�'ALES DE LA CAMARA 	
	**************************************************************************/
	
	/*simulación de contador de pixeles para  general Href y vsync*/
	initial forever  begin
	//	CAM_px_data=~CAM_px_data;
		@(posedge pclk) begin
		if (img_generate==1) begin
			line_cnt=line_cnt+1;
			if (line_cnt >TAM_LINE-1+BLACK_TAM_LINE) begin
				line_cnt=0;
				row_cnt=row_cnt+1;
				if (row_cnt>TAM_ROW-1+BLACK_TAM_ROW) begin
					row_cnt=0;
				end
			end
		end
		end
	end

	/*simulación de la señal vsync generada por la camara*/	
	initial forever  begin
		@(posedge pclk) begin 
		if (img_generate==1) begin
			if (row_cnt==0)begin
				CAM_vsync  = 1;
			end 
			if (row_cnt==BLACK_TAM_ROW/2)begin
				CAM_vsync  = 0;
			end
		end
		end
	end
	
	/*simulación de la señal href generada por la camara*/	
	initial forever  begin
		@(negedge pclk) begin 
		if (img_generate==1) begin
		if (row_cnt>BLACK_TAM_ROW-1)begin
			if (line_cnt==0)begin
				CAM_href  = 1; 
			end
		end
			if (line_cnt==TAM_LINE)begin
				CAM_href  = 0;
			end
		end
		end
	end
	
	//SIMULACON CAMBIO DE COLORES BARRA
	//A�adimos este ciclo para variar el color de CAM_
	initial forever begin
		@(negedge pclk) begin
		if (img_generate==1 && CAM_href==1) begin
			if(count==0) begin
				color = color_data[127:112];
				color_data = color_data*65536+color;
			end
			CAM_px_data = color[15:8];
			color = color*256+CAM_px_data;
			count=count+1;
		end
		end
	end

	/*************************************************************************
			FIN SIMULACIÒN DE SEÑALES DE LA CAMARA 	
	**************************************************************************/
	
	/*************************************************************************
			INICIO DE  GENERACION DE ARCHIVO test_vga	
	**************************************************************************/

	/* log para cargar de archivo*/
	integer f;
	initial begin
      f = $fopen("test_vga.txt","w");
   end
	
	reg clk_w =0;
	always #1 clk_w  = ~clk_w;
	
	/* ecsritura de log para cargar se cargados en https://ericeastwood.com/lab/vga-simulator/*/
	initial forever begin
	@(posedge clk_w)
		$fwrite(f,"%0t ps: %b %b %b %b %b\n",$time,VGA_Hsync_n, VGA_Vsync_n, VGA_R[3:1],VGA_G[3:1],VGA_B[3:2]);
	end
	
endmodule
