unal-edigital1-2019-2/work04-proyectofinal-grupo-02-1/(commit log)

2020-02-10 modulo captura de datos
2020-02-11 Proyecto Final
    Carga de imagenes, carga de proyecto, carga del codigo arduino.
    [m_00000000000293240281_0898626419.nt64.obj, m_00000000001073926473_1206468233.nt64.obj, m_00000000001433017019_1742765518.nt64.obj, m_00000000001964925841_2406606927.nt64.obj, m_00000000001994499703_2888191379.nt64.obj, m_00000000002068633926_3409011990.nt64.obj, m_00000000003266096158_2593380106.nt64.obj, m_00000000004134447467_2073120511.nt64.obj]
2020-02-11 Configuracion correcta de la camara
    [OV7670_config.ino]
